onurefe/BernoulliFlowSensor/README.md

# BernoulliFlowSensor
Measuring phase shifts occurs during transmitting sound, this device determines local gas velocity vector at very high rates such as 1KHz.
