onurefe/BernoulliFlowSensor/Hardware/BOM.ods

Item | Value | Link | Cost per item(100units) | Quantity | Cost
C2, C4-C7, C17, C22 | 1u | https://www.digikey.com/product-detail/en/kemet/C0603C105K9PACTU/399-7848-1-ND/3471571 | $0.03 | 7 | $0.23
C8, C10 | 18p | https://www.digikey.com/product-detail/en/kemet/C0603C180J5GACTU/399-1052-1-ND/411327 | $0.02 | 2 | $0.04
C1, C3, C9, C11-C13, C15, C16, C18, C20 | 100n | https://www.digikey.com/product-detail/en/yageo/CC0603ZRY5V9BB104/311-1343-1-ND/2103127 | $0.02 | 10 | $0.24
C14 | 4.7u 6.3v | https://www.digikey.com/product-detail/en/avx-corporation/TAJA475K010TNJ/478-11183-1-ND/7567030 | $0.12 | 1 | $0.12
J1 | Conn_01x04_Male |  |  | 1 | $0.00
J2 | USB_B_Mini | https://www.digikey.com/product-detail/en/edac-inc/690-005-299-043/151-1206-1-ND/4312192 | $0.43 | 1 | $0.43
J3 | Conn_01x05_Male |  |  | 1 | $0.00
J4 | Conn_01x02_Male |  |  | 1 | $0.00
LS1-LS4 | Speaker_Crystal | https://tr.aliexpress.com/item/1649076095.html | $1.00 | 4 | $4.00
Q1-Q4 | 2N7002 | https://www.digikey.com/product-detail/en/nexperia-usa-inc/2N7002NXAKR/1727-8643-1-ND/10416560 | $0.03 | 4 | $0.13
R1, R2 | 4.7k | https://www.digikey.com/product-detail/en/yageo/RC0603FR-074K7L/311-4.70KHRCT-ND/730159 | $0.01 | 2 | $0.02
R3 | 10k | https://www.digikey.com/product-detail/en/yageo/RC0603JR-0710KL/311-10KGRCT-ND/729647 | $0.01 | 1 | $0.01
R6, R9 | 10k | https://www.digikey.com/product-detail/en/yageo/RC0603FR-0710KL/311-10-0KHRCT-ND/729827 | $0.01 | 2 | $0.02
R4, R5, R7, R8 | 100k | https://www.digikey.com/product-detail/en/stackpole-electronics-inc/RMCF0603FT100K/RMCF0603FT100KCT-ND/1943118 | $0.01 | 4 | $0.03
R10, R11 | 100k | https://www.digikey.com/product-detail/en/stackpole-electronics-inc/RMCF0603FT100K/RMCF0603FT100KCT-ND/1943118 | $0.01 | 2 | $0.01
R12-R14 | 33R | https://www.digikey.com/product-detail/en/te-connectivity-passive-product/CRGCQ0603F33R/A129670CT-ND/8577502 | $0.01 | 3 | $0.04
R15 | 1.5k | https://www.digikey.com/product-detail/en/te-connectivity-passive-product/CRGCQ0603J1K5/A130092CT-ND/8577924 | $0.01 | 1 | $0.01
R16-R23 | 4.7k | https://www.digikey.com/product-detail/en/yageo/RC0603JR-074K7L/311-4-7KGRCT-ND/729732 | $0.01 | 8 | $0.06
U1 | TS3A5018PWR | https://www.digikey.com/product-detail/en/texas-instruments/TS3A5018PWR/296-17612-1-ND/705743 | $0.47 | 2 | $0.94
U2 | MCP6002-xSN | https://www.digikey.com/product-detail/en/microchip-technology/MCP6002T-I-SN/MCP6002T-I-SNCT-ND/4307905 | $0.25 | 1 | $0.25
U3 | STM32F070F6Px | https://www.digikey.com/product-detail/en/stmicroelectronics/STM32F070F6P6TR/497-17354-1-ND/8024125 | $1.03 | 1 | $1.03
U4, U5 | MIC5504-3.3YM5 | https://www.digikey.com/product-detail/en/microchip-technology/MIC5504-3-3YM5-TR/576-4764-1-ND/4864028 | $0.08 | 2 | $0.16
U12 | NUF2221W6 | https://www.digikey.com/product-detail/en/on-semiconductor/NUF2221W1T2G/NUF2221W1T2GOSCT-ND/720929 | $0.30 | 1 | $0.30
Y1 | 8MHZ | https://www.digikey.com/product-detail/en/jauch-quartz/J49SMH-F-G-G-K-8M0/1908-J49SMH-F-G-G-K-8M0CT-ND/10416298 | $0.16 | 1 | $0.16
Grand total cost | $8.22
