onurefe/BernoulliFlowSensor/Hardware/Schematic/Ultrasonic Flow Sensor.kicad_pcb

## KiCad design Hardware/Schematic/Ultrasonic Flow Sensor.kicad_pcb (2020-06-06)

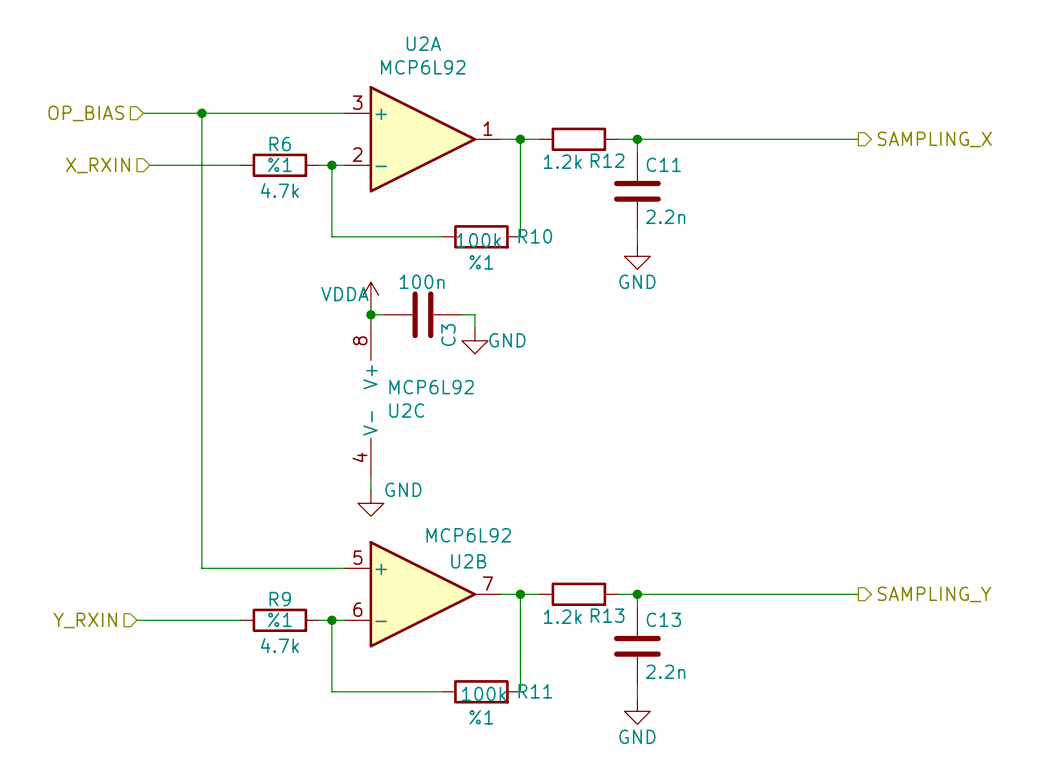
[picture p1: schematic AnalogFrontend.sch]

Parts:
C3: 100n; C_0603_1608Metric
C11, C13: 2.2n; C_0603_1608Metric
R6, R9: 4.7k; R_0603_1608Metric; Tolerance %1
R10, R11: 100k; R_0603_1608Metric; Tolerance %1
R12, R13: 1.2k; R_0603_1608Metric
U2: MCP6L92; SOIC-8_3.9x4.9mm_P1.27mm

Connections:
/OP_BIAS: U2.3 (+), U2.5 (+); also elsewhere on the board
/RX_X: R6.1; also elsewhere on the board
/RX_Y: R9.1; also elsewhere on the board
/SAMPLING_X: C11.1, R12.2; also elsewhere on the board
/SAMPLING_Y: C13.1, R13.2; also elsewhere on the board
GND: C3.1, C11.2, C13.2, U2.4 (V-); also elsewhere on the board
unnamed: R6.2, R10.1, U2.2 (-)
unnamed: R10.2, R12.1, U2.1
unnamed: R9.2, R11.1, U2.6 (-)
unnamed: R11.2, R13.1, U2.7
VDDA: C3.2, U2.8 (V+); also elsewhere on the board

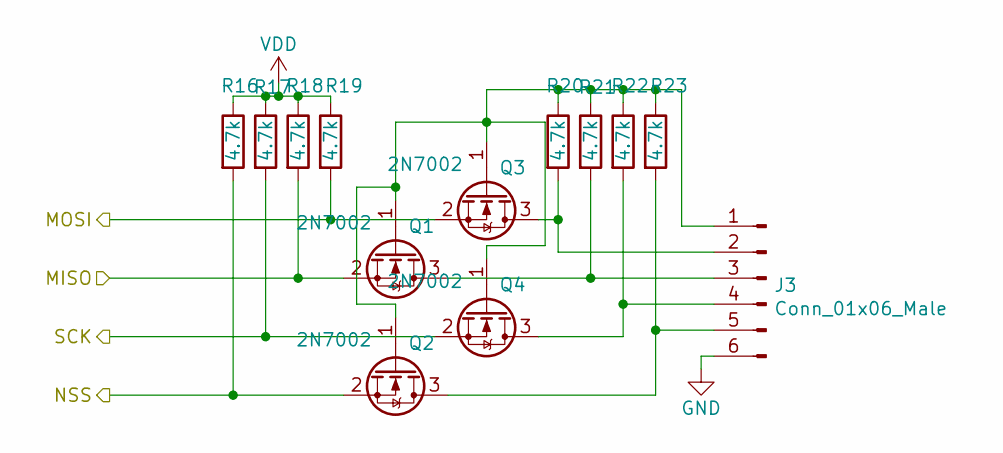
[picture p2: schematic LogicLevelConverter.sch]

Parts:
J3: Conn_01x06_Male; PinHeader_1x06_P2.54mm_Vertical
Q1, Q2, Q3, Q4: 2N7002; SOT-23
R16, R17, R18, R19, R20, R21, R22, R23: 4.7k; R_0603_1608Metric

Connections:
/MISO: Q1.2 (S), R18.2; also elsewhere on the board
/MOSI: Q3.2 (S), R19.2; also elsewhere on the board
/NSS: Q2.2 (S), R16.2; also elsewhere on the board
/SCK: Q4.2 (S), R17.2; also elsewhere on the board
GND: J3.6; also elsewhere on the board
unnamed: J3.1, Q1.1 (G), Q2.1 (G), Q3.1 (G), Q4.1 (G), R20.1, R21.1, R22.1, R23.1
unnamed: J3.2, Q3.3 (D), R20.2
unnamed: J3.3, Q1.3 (D), R21.2
unnamed: J3.4, Q4.3 (D), R22.2
unnamed: J3.5, Q2.3 (D), R23.2
VDD: R16.1, R17.1, R18.1, R19.1; also elsewhere on the board

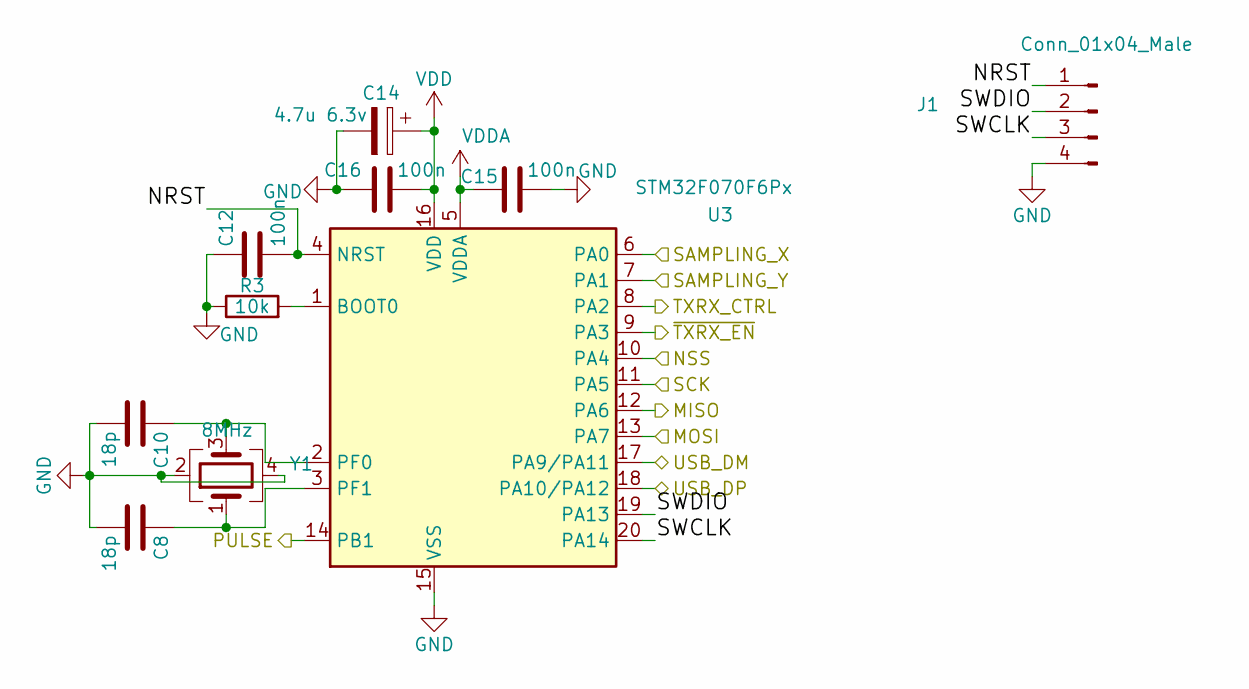
[picture p3: schematic Mcu.sch]

Parts:
C8, C10: 18p; C_0603_1608Metric
C12, C15, C16: 100n; C_0603_1608Metric
C14: 4.7u 6.3v; C_1206_3216Metric
J1: Conn_01x04_Male; PinHeader_1x04_P2.54mm_Vertical
R3: 10k; R_0603_1608Metric
U3: STM32F070F6Px; TSSOP-20_4.4x6.5mm_P0.65mm
Y1: 8MHz; Crystal_5x3.2mm_4leads

Connections:
/MISO: U3.12 (PA6); also elsewhere on the board
/MOSI: U3.13 (PA7); also elsewhere on the board
/Mcu/NRST: C12.2, J1.1, U3.4 (NRST)
/Mcu/SWCLK: J1.3, U3.20 (PA14)
/Mcu/SWDIO: J1.2, U3.19 (PA13)
/NSS: U3.10 (PA4); also elsewhere on the board
/PULSE: U3.14 (PB1); also elsewhere on the board
/SAMPLING_X: U3.6 (PA0); also elsewhere on the board
/SAMPLING_Y: U3.7 (PA1); also elsewhere on the board
/SCK: U3.11 (PA5); also elsewhere on the board
/TXRX_CTRL: U3.8 (PA2); also elsewhere on the board
/USB_DM: U3.17 (PA9/PA11); also elsewhere on the board
/USB_DP: U3.18 (PA10/PA12); also elsewhere on the board
/~TXRX_EN: U3.9 (PA3); also elsewhere on the board
GND: C8.2, C10.2, C12.1, C14.2, C15.2, C16.1, J1.4, R3.1, U3.15 (VSS), Y1.2, Y1.4; also elsewhere on the board
unnamed: C8.1, U3.3 (PF1), Y1.1
unnamed: C10.1, U3.2 (PF0), Y1.3
unnamed: R3.2, U3.1 (BOOT0)
VDD: C14.1, C16.2, U3.16 (VDD); also elsewhere on the board
VDDA: C15.1, U3.5 (VDDA); also elsewhere on the board

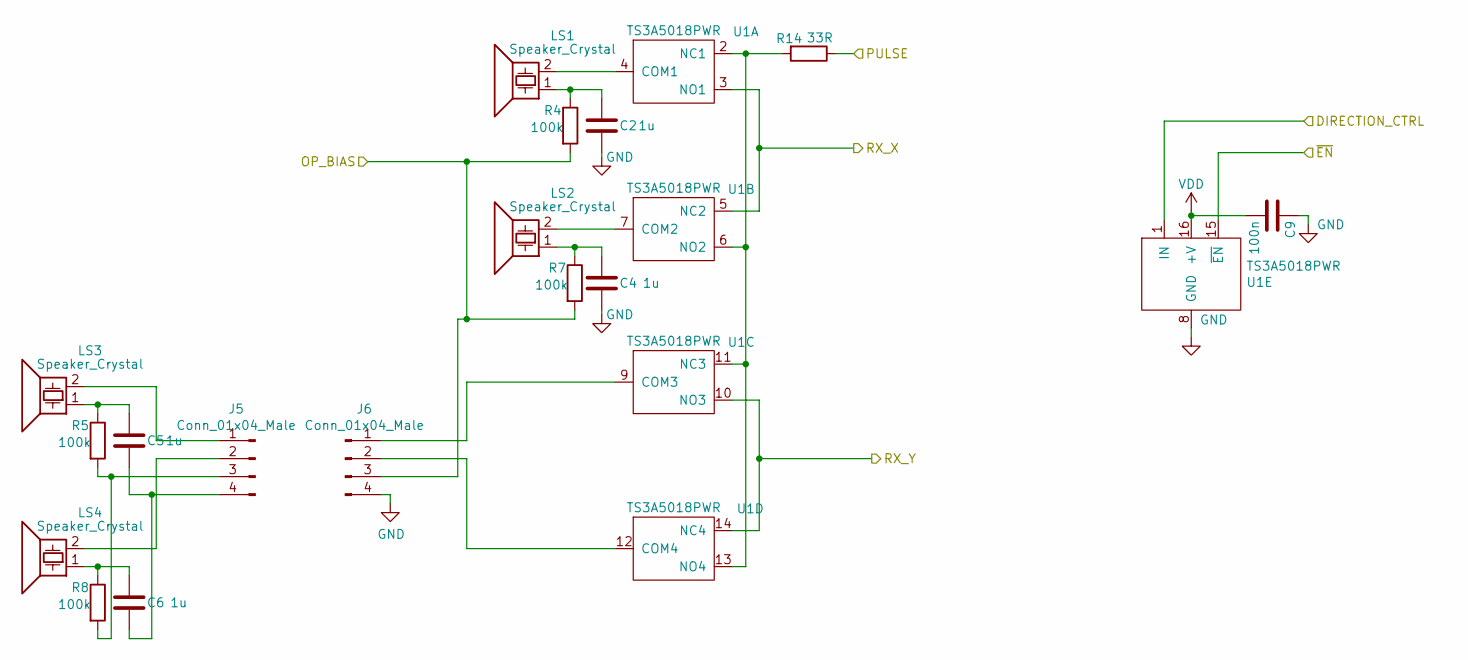
[picture p4: schematic TxRx.sch]

Parts:
C2, C4, C5, C6: 1u; C_0603_1608Metric
C9: 100n; C_0603_1608Metric
J5, J6: Conn_01x04_Male; JST_EH_B4B-EH-A_1x04_P2.50mm_Vertical
LS1, LS2, LS3, LS4: Speaker_Crystal; ultrasound_piezo_round_D10mmxP6mm
R4, R5, R7, R8: 100k; R_0603_1608Metric
R14: 33R; R_0603_1608Metric
U1: TS3A5018PWR; TSSOP-16_4.4x5mm_P0.65mm

Connections:
/OP_BIAS: J6.3, R4.2, R7.2; also elsewhere on the board
/PULSE: R14.1; also elsewhere on the board
/RX_X: U1.3 (NO1), U1.5 (NC2); also elsewhere on the board
/RX_Y: U1.10 (NO3), U1.14 (NC4); also elsewhere on the board
/TXRX_CTRL: U1.1 (IN); also elsewhere on the board
/~TXRX_EN: U1.15 (~EN); also elsewhere on the board
GND: C2.2, C4.2, C9.1, J6.4, U1.8 (GND); also elsewhere on the board
unnamed: C2.1, LS1.1, R4.1
unnamed: C4.1, LS2.1, R7.1
unnamed: C5.1, LS3.1, R5.1
unnamed: C5.2, C6.2, J5.4
unnamed: C6.1, LS4.1, R8.1
unnamed: J5.1, LS3.2
unnamed: J5.2, LS4.2
unnamed: J5.3, R5.2, R8.2
unnamed: J6.1, U1.9 (COM3)
unnamed: J6.2, U1.12 (COM4)
unnamed: LS1.2, U1.4 (COM1)
unnamed: LS2.2, U1.7 (COM2)
unnamed: R14.2, U1.2 (NC1), U1.6 (NO2), U1.11 (NC3), U1.13 (NO4)
VDD: C9.2, U1.16 (+V); also elsewhere on the board

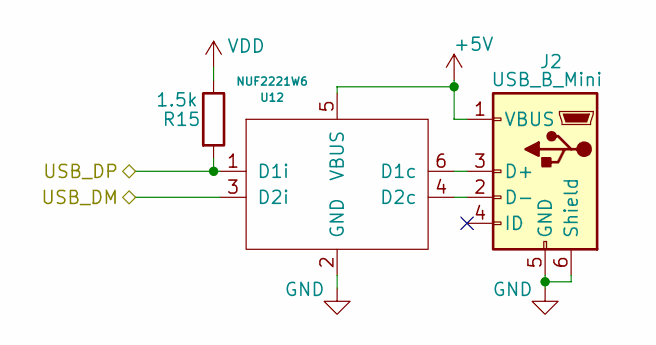
[picture p5: schematic Usb.sch]

Parts:
J2: USB_B_Mini; USB_Mini-B_Wuerth_65100516121_Horizontal
R15: 1.5k; R_0603_1608Metric
U12: NUF2221W6; SOT-363_SC-70-6

Connections:
+5V: J2.1 (VBUS), U12.5 (VBUS); also elsewhere on the board
/USB_DM: U12.3 (D2i); also elsewhere on the board
/USB_DP: R15.2, U12.1 (D1i); also elsewhere on the board
GND: J2.5 (GND), J2.6 (Shield), U12.2 (GND); also elsewhere on the board
unnamed: J2.2 (D-), U12.4 (D2c)
unnamed: J2.3 (D+), U12.6 (D1c)
VDD: R15.1; also elsewhere on the board

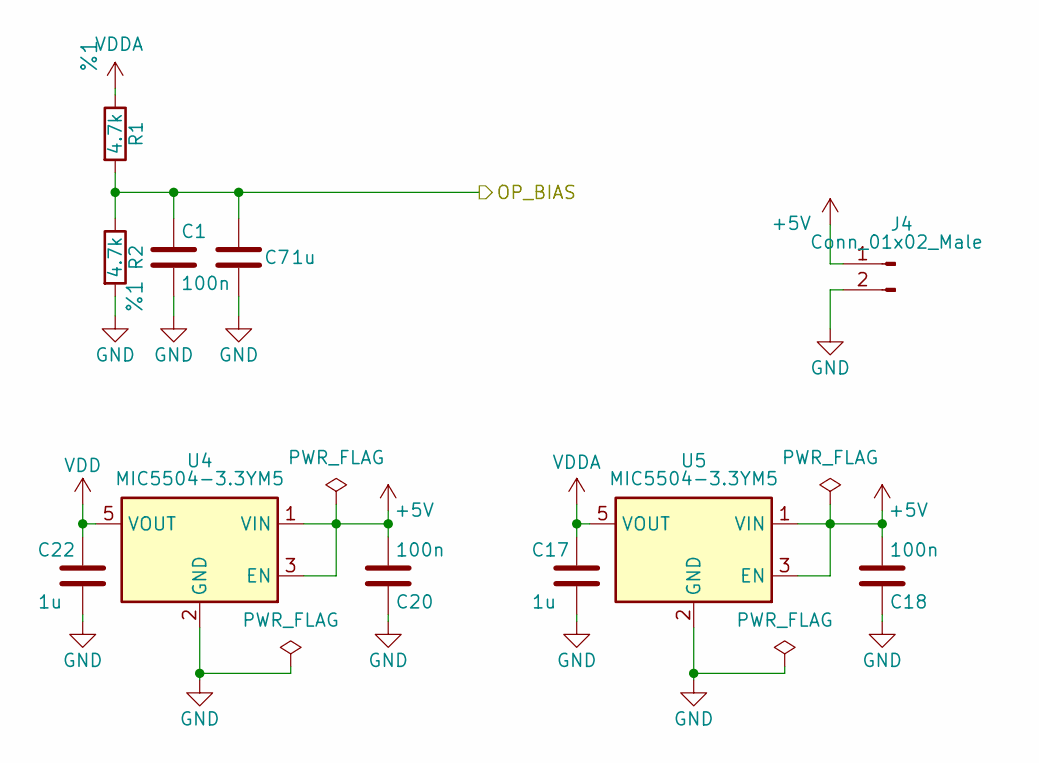
[picture p6: schematic Voltage.sch]

Parts:
C1, C18, C20: 100n; C_0603_1608Metric
C7, C17, C22: 1u; C_0603_1608Metric
J4: Conn_01x02_Male; PinHeader_1x02_P2.54mm_Vertical
R1, R2: 4.7k; R_0603_1608Metric; Tolerance %1
U4, U5: MIC5504-3.3YM5; SOT-23-5

Connections:
+5V: C18.2, C20.2, J4.1, U4.1 (VIN), U4.3 (EN), U5.1 (VIN), U5.3 (EN); also elsewhere on the board
/OP_BIAS: C1.1, C7.1, R1.2, R2.1; also elsewhere on the board
GND: C1.2, C7.2, C17.2, C18.1, C20.1, C22.2, J4.2, R2.2, U4.2 (GND), U5.2 (GND); also elsewhere on the board
VDD: C22.1, U4.5 (VOUT); also elsewhere on the board
VDDA: C17.1, R1.1, U5.5 (VOUT); also elsewhere on the board

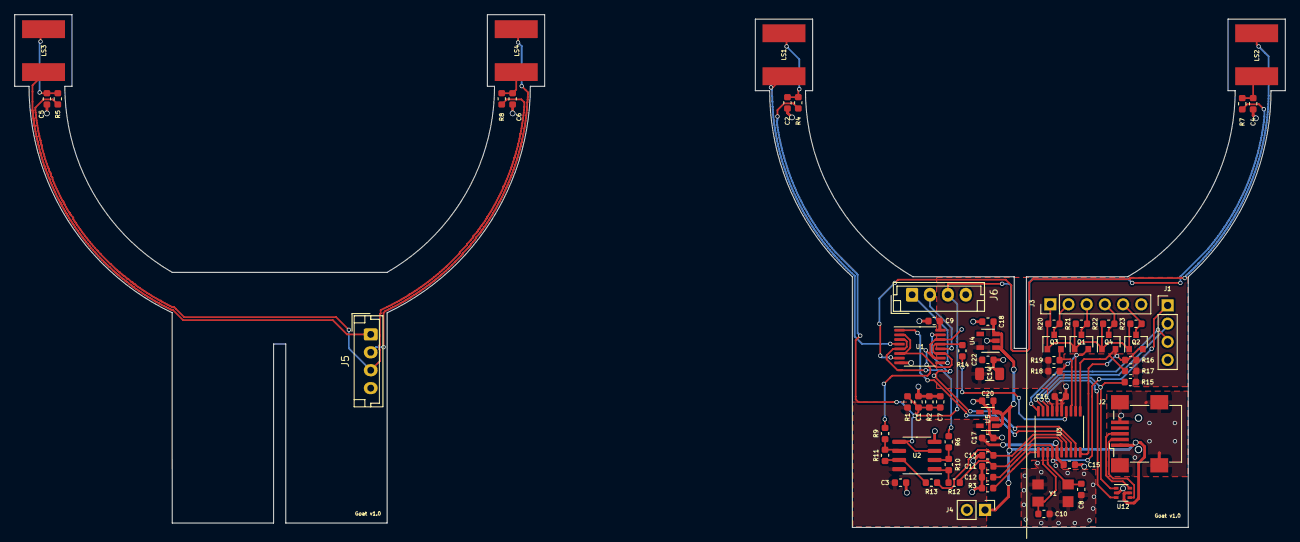
[picture p7: board Ultrasonic Flow Sensor.kicad_pcb from above]

Board: 2 copper layers, 74.0 x 71.0 mm, 64 parts (0 on the bottom side), 48 nets.
