onurefe/BernoulliFlowSensor/Embedded/Src/main.c

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

/* Includes ------------------------------------------------------------------*/
#include "main.h"
#include "usb_device.h"

/* USER CODE BEGIN Includes */
#include "flow.h"
#include "usbd_cdc_if.h"
/* USER CODE END Includes */

/* USER CODE BEGIN PD */
#define FT_SAMPLES FLOW_FT_SAMPLES_128
#define FT_DISCARDED_SAMPLES FLOW_FT_SAMPLES_16
/* USER CODE END PD */


/* USER CODE BEGIN PV */
static uint16_t ADCBuffer[__FLOW_GET_ADC_BUFFER_SIZE(FT_SAMPLES)];
static uint8_t USBTxBuffer[64];

/* USER CODE END PV */

void SystemClock_Config(void);
static void MX_GPIO_Init(void);
static void MX_DMA_Init(void);
static void MX_ADC_Init(void);
static void MX_SPI1_Init(void);
static void MX_TIM1_Init(void);
static void MX_TIM3_Init(void);

/* USER CODE BEGIN PFP */
static uint16_t toCharArray(uint8_t *buffer, int32_t num);
/* USER CODE END PFP */

/**
  * @brief  The application entry point.
  * @retval int
  */
int main(void)
{
  /* MCU Configuration--------------------------------------------------------*/

  /* Reset of all peripherals, Initializes the Flash interface and the Systick. */
  HAL_Init();

  /* Configure the system clock */
  SystemClock_Config();

  /* Initialize all configured peripherals */
  MX_GPIO_Init();
  MX_DMA_Init();
  MX_ADC_Init();
  MX_SPI1_Init();
  MX_TIM1_Init();
  MX_TIM3_Init();
  MX_USB_DEVICE_Init();

  /* USER CODE BEGIN 2 */
  Flow_Init(ADCBuffer, 25, FT_SAMPLES, FT_DISCARDED_SAMPLES);
  Flow_Start();
  /* USER CODE END 2 */

  /* Infinite loop */
  /* USER CODE BEGIN WHILE */
  while (1)
  {
    /* USER CODE END WHILE */
    Flow_Execute();
    /* USER CODE BEGIN 3 */
  }
  /* USER CODE END 3 */
}

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
/* USER CODE BEGIN 4 */
void Flow_MeasurementCompletedCb(float xVelocity, float yVelocity)
{
  int32_t x_int, y_int;
  int idx = 0;

  x_int = (int32_t)(xVelocity * 1000.0);
  if (x_int < 0.0f)
    x_int = -x_int;

  USBTxBuffer[idx++] = 'X';
  USBTxBuffer[idx++] = ':';

  if (xVelocity < 0.0f)
    USBTxBuffer[idx++] = '-';

  idx = toCharArray(&USBTxBuffer[idx], (x_int / 1000));
  USBTxBuffer[idx++] = '.';
  idx = toCharArray(&USBTxBuffer[idx], (x_int % 1000));

  if (Flow_IsEnabledYAxis())
  {
    y_int = (int32_t)(yVelocity * 1000.0);

    if (y_int < 0.0f)
      y_int = -y_int;

    USBTxBuffer[idx++] = ' ';
    USBTxBuffer[idx++] = 'Y';
    USBTxBuffer[idx++] = ':';

    if (yVelocity < 0.0f)
      USBTxBuffer[idx++] = '-';
    
    idx = toCharArray(&USBTxBuffer[idx], (y_int / 1000));
    USBTxBuffer[idx++] = '.';
    idx = toCharArray(&USBTxBuffer[idx], (y_int % 1000));
  }

  USBTxBuffer[idx++] = '\n';
  USBTxBuffer[idx++] = '\r';

  CDC_Transmit_FS(USBTxBuffer, idx);
}

static uint16_t toCharArray(uint8_t *buffer, int32_t num)
{
  int i, rem, len = 0, n;

  n = num;
  while (n != 0)
  {
    len++;
    n /= 10;
  }
  for (i = 0; i < len; i++)
  {
    rem = num % 10;
    num = num / 10;
    buffer[len - (i + 1)] = rem + '0';
  }

  return len;
}

/* USER CODE END 4 */
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
