onurefe/BernoulliFlowSensor/Embedded/Embedded.ioc

Mcu.UserName=STM32F070F6Px
PA0.GPIO_Label=SAMPLING_X
PA0.Signal=ADC_IN0
PA1.GPIO_Label=SAMPLING_Y
PA1.Signal=ADC_IN1
PA11.Signal=USB_DM
PA12.Signal=USB_DP
PA13.GPIO_Label=SWDIO
PA13.Signal=SYS_SWDIO
PA14.GPIO_Label=SWCLK
PA14.Signal=SYS_SWCLK
PA2.GPIO_Label=TXRX_CTRL
PA2.Signal=GPIO_Output
PA3.GPIO_Label=TXRX_nEN
PA3.Signal=GPIO_Output
PA4.GPIO_Label=NSS
PA4.Signal=SPI1_NSS
PA5.GPIO_Label=SCK
PA5.Signal=SPI1_SCK
PA6.GPIO_Label=MISO
PA6.Signal=SPI1_MISO
PA7.GPIO_Label=MOSI
PA7.Signal=SPI1_MOSI
PB1.GPIO_Label=PULSE
PB1.Signal=TIM1_CH3N
PF0-OSC_IN.Signal=RCC_OSC_IN
PF1-OSC_OUT.Signal=RCC_OSC_OUT
