onurefe/BernoulliFlowSensor/(commit log)

2020-06-06 Hardware and firmware components written, not tested.
    [AnalogFrontend.sch, BOM.ods, LogicLevelConverter.sch, Mcu.sch, TxRx.sch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]
2020-09-02 Kicad v5 files added.
    [AnalogFrontend.sch, LogicLevelConverter.sch, Mcu.sch, TxRx.sch, Ultrasonic Flow Sensor.sch, Usb.sch, Voltage.sch]
